bwack/CASEFANCTRLx8/pcb rework modification/oshpark_preview_front.png

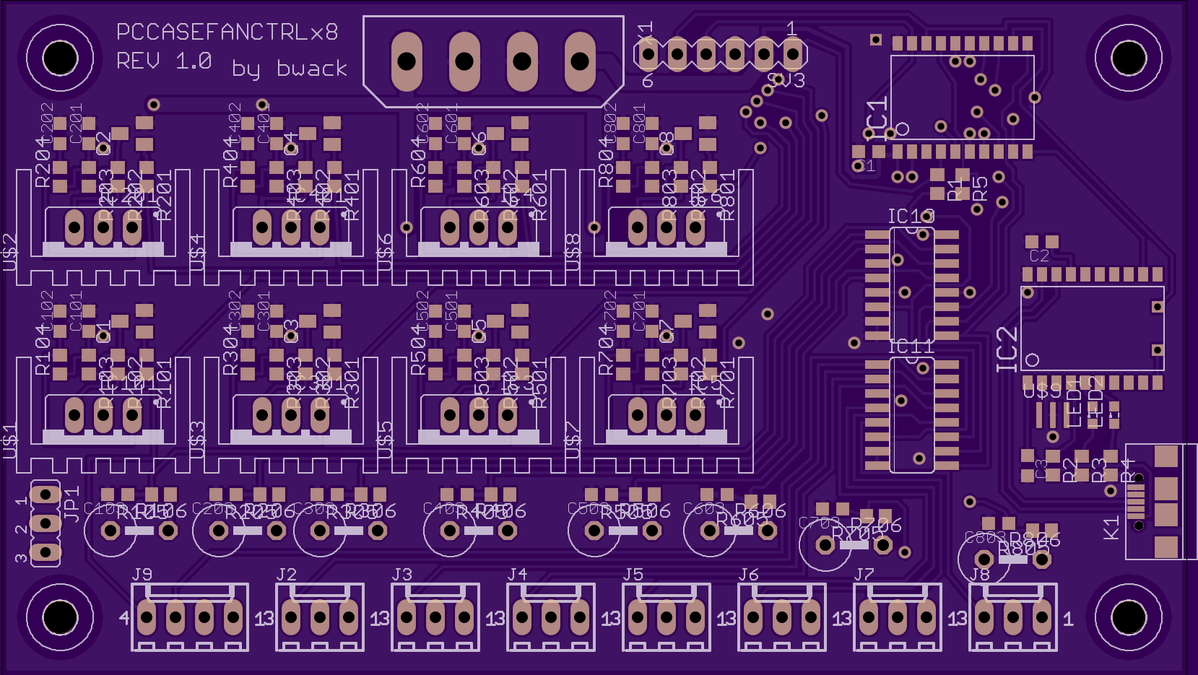
pcb rework modification/oshpark_preview_front.png
