bwack/CASEFANCTRLx8/pcb rework modification/oshpark_preview_rear_.png

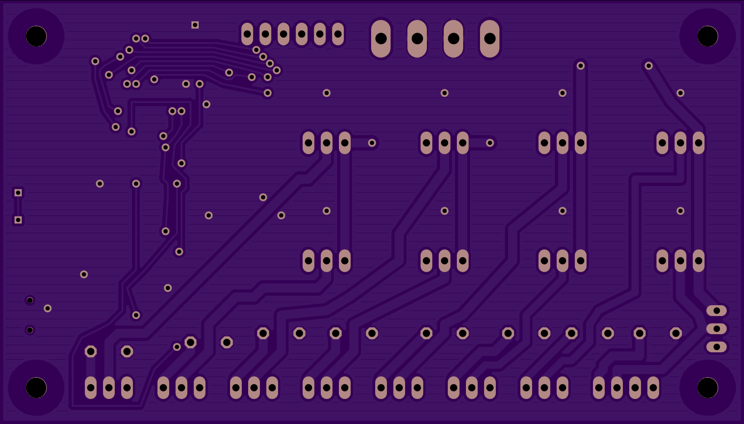
pcb rework modification/oshpark_preview_rear_.png
