bwack/CASEFANCTRLx8/pccasefanctrlx8_layout.pdf

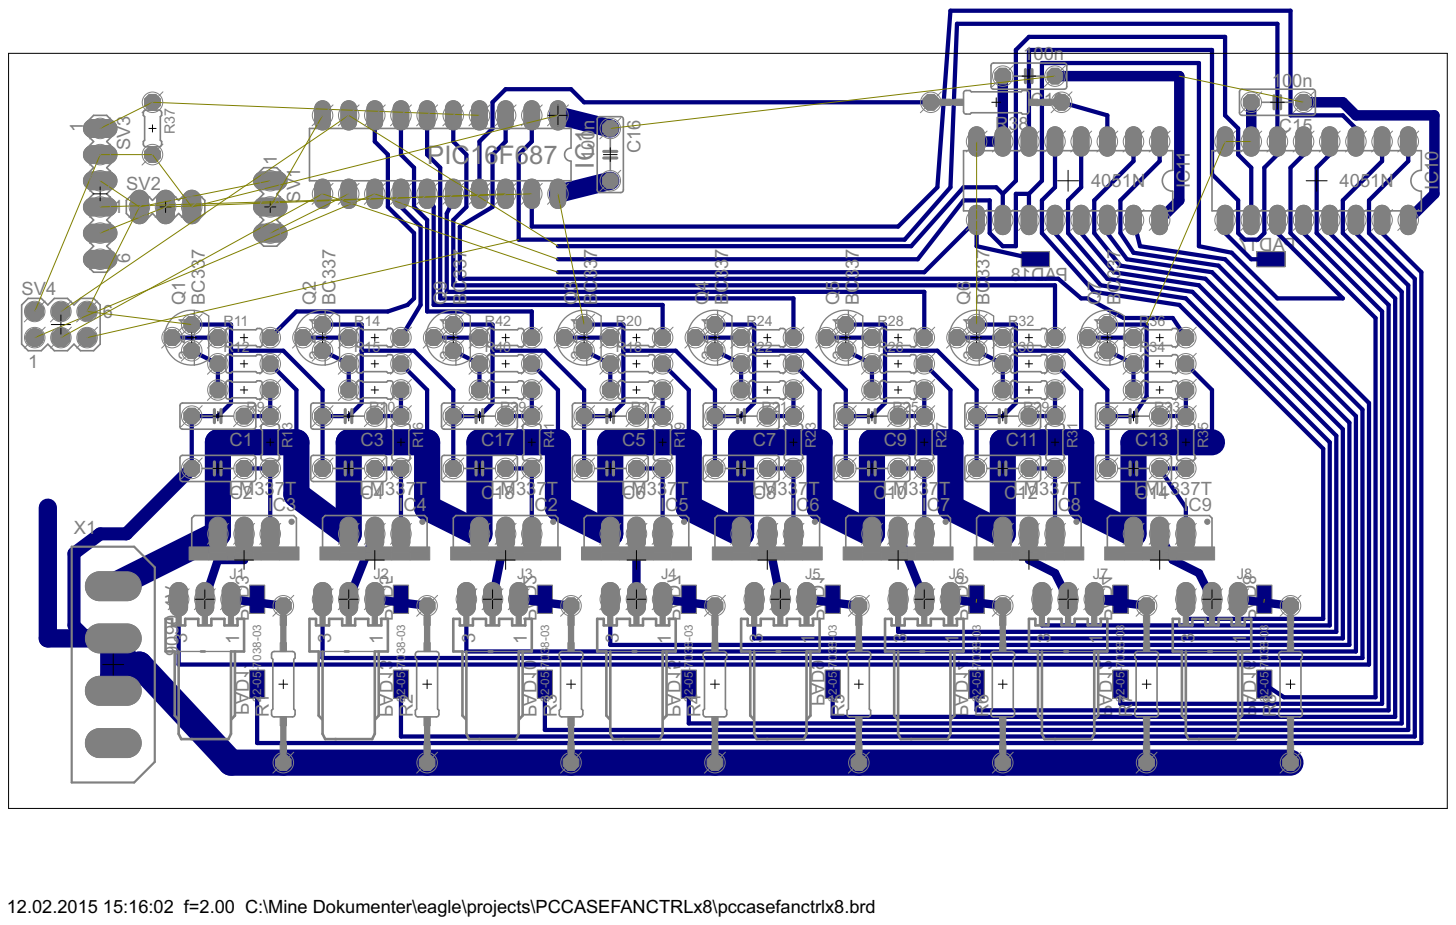
[picture p3: page 1]

12.02.2015 15:16:02 f=2.00 C:\Mine Dokumenter\eagle\projects\PCCASEFANCTRLx8\pccasefanctrlx8.brd
