bwack/CASEFANCTRLx8/pccasefanctrlx8_sch.pdf

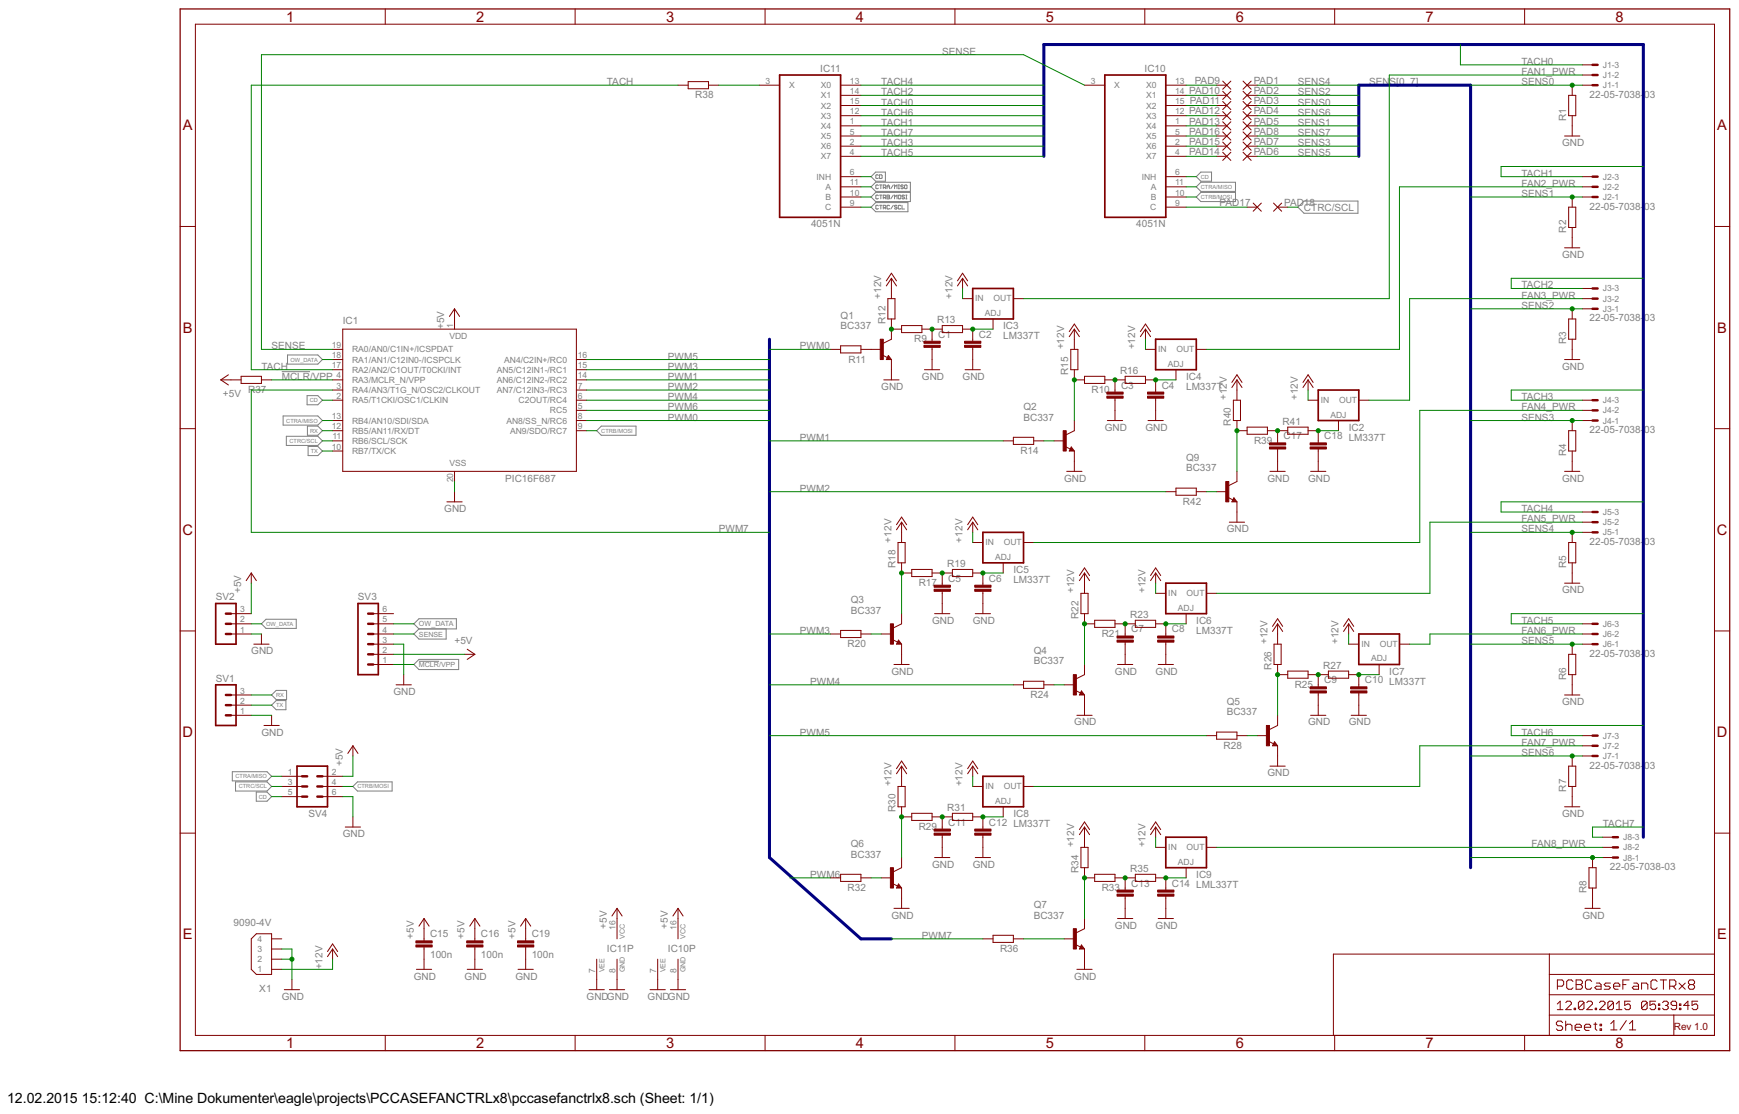
[picture p4: page 1]

12.02.2015 15:12:40 C:\Mine Dokumenter\eagle\projects\PCCASEFANCTRLx8\pccasefanctrlx8.sch (Sheet: 1/1)
