bwack/CASEFANCTRLx8/pccasefanctrlx8.brd

## EAGLE design pccasefanctrlx8.brd (2016-09-14)

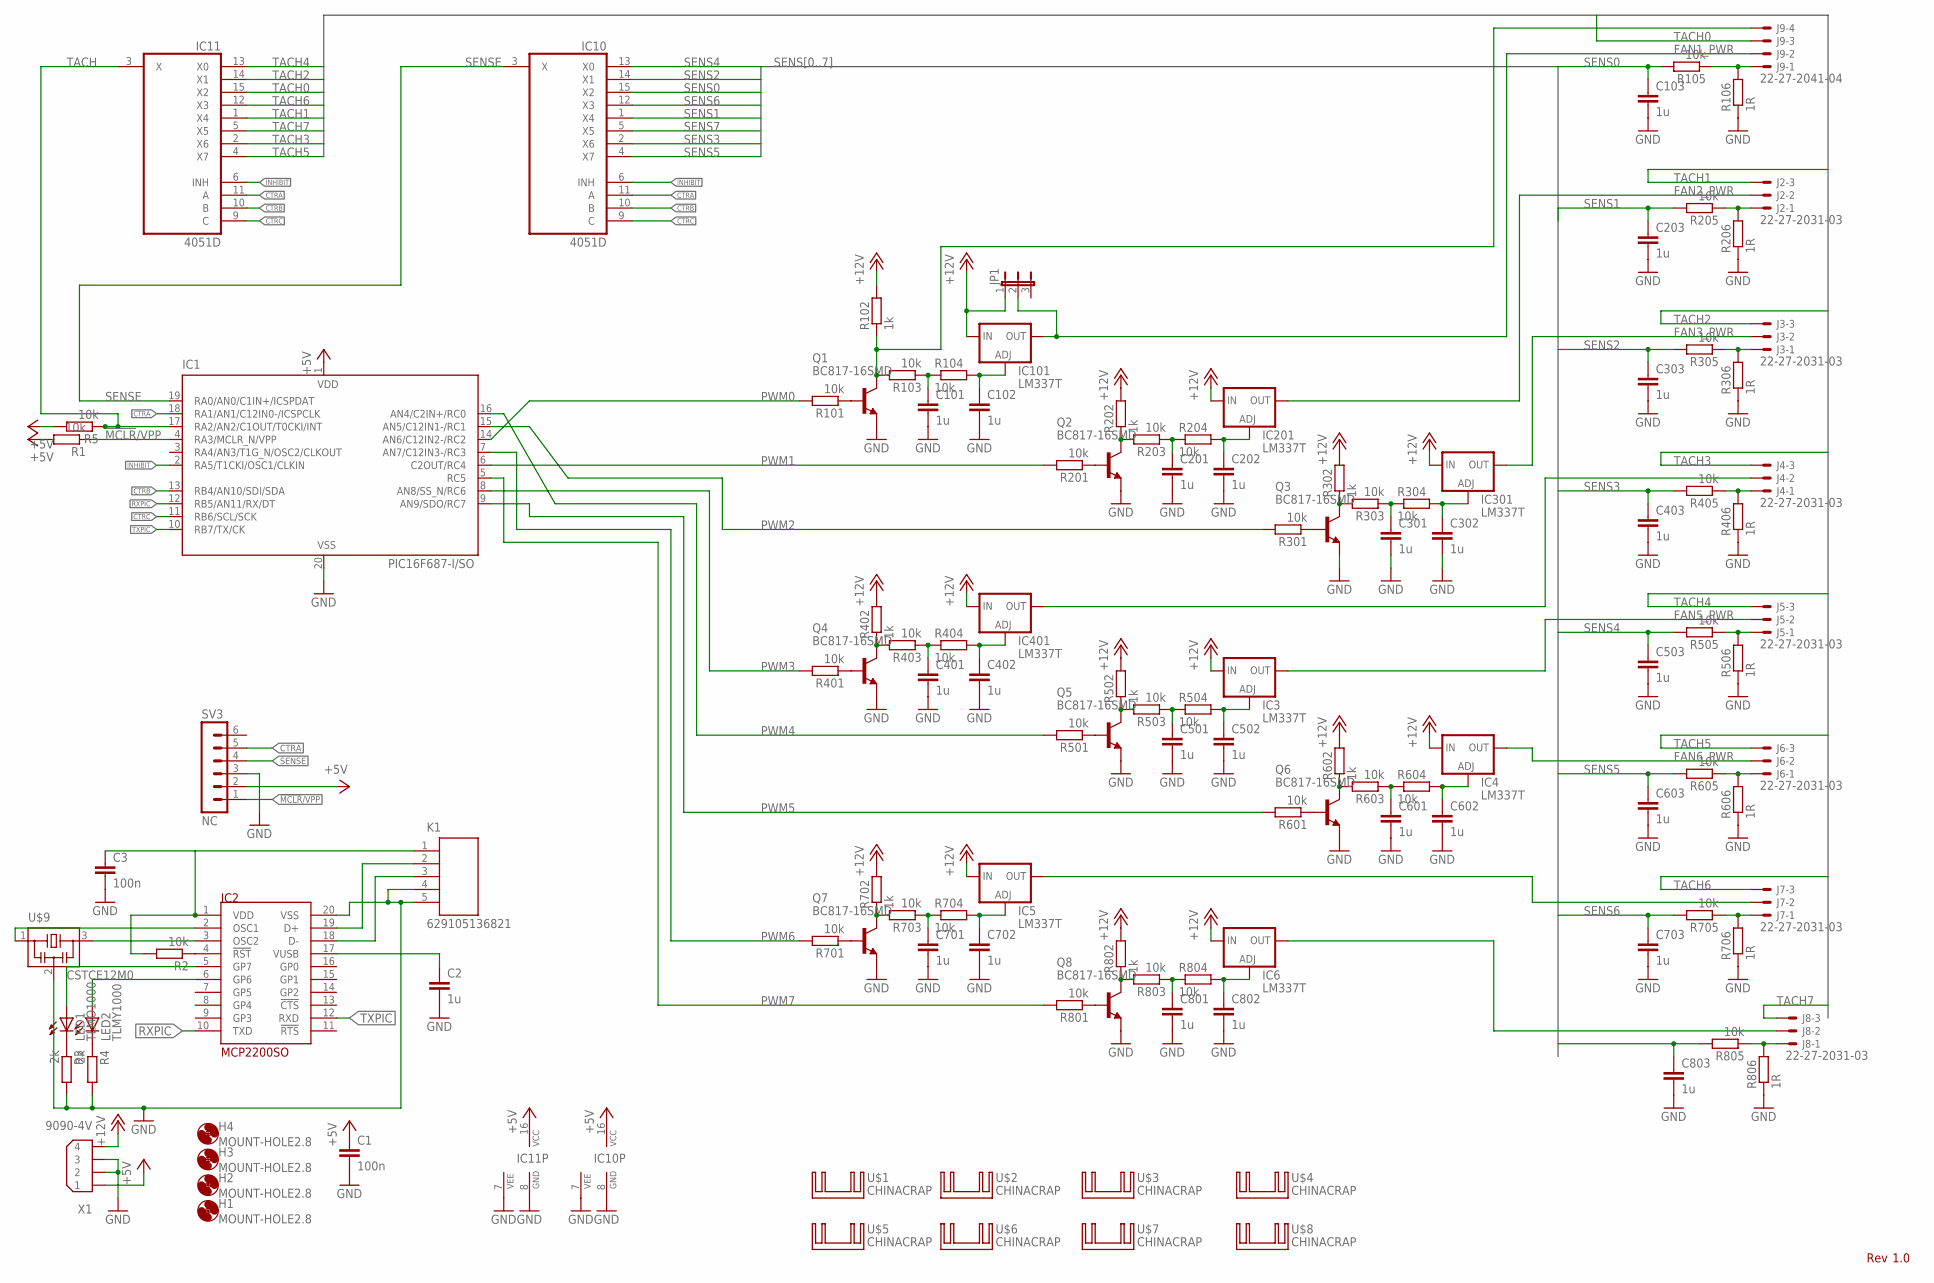
[picture p5: schematic pccasefanctrlx8.sch]

Parts:
C1, C3: 100n; C0603K
C2, C101, C102, C103, C201, C202, C203, C301, C302, C303, C401, C402, C403, C501, C502, C503, C601, C602, C603, C701, C702, C703, C801, C802, C803: 1u; C0603K
H1, H2, H3, H4: MOUNT-HOLE2.8; 2,8
IC1: PIC16F687-I/SO; SO-20W
IC2: MCP2200SO; SO-20W
IC3, IC4, IC5, IC6, IC101, IC201, IC301, IC401: LM337T; 317TS
IC10, IC11: 4051D; SO16
J2, J3, J4, J5, J6, J7, J8: 22-27-2031-03; 6410-03
J9: 22-27-2041-04; 6410-04
JP1: JP2E; JP2
K1: 629105136821
LED1: TLMO1000; SML0603
LED2: TLMY1000; SML0603
Q1, Q2, Q3, Q4, Q5, Q6, Q7, Q8: BC817-16SMD; SOT23-BEC
R1, R2, R5, R101, R103, R104, R105, R201, R203, R204, R205, R301, R303, R304, R305, R401, R403, R404, R405, R501, R503, R504, R505, R601, R603, R604, R605, R701, R703, R704, R705, R801, R803, R804, R805: 10k; R0603
R3, R4: 2k; R0603
R102, R202, R302, R402, R502, R602, R702, R802: 1k; R0603
R106, R206, R306, R406, R506, R606, R706, R806: 1R; P0613V
SV3: NC; MA06-1
U$1, U$2, U$3, U$4, U$5, U$6, U$7, U$8: CHINACRAP; MYCHINACRAP
U$9: CSTCE12M0; CSTCE_G
X1: 9090-4V

Connections:
!MCLR!/VPP: IC1.4 (RA3/MCLR_N/VPP), R1.1, SV3.1
+5V: C1.1, IC1.1 (VDD), IC10.16 (VCC), IC11.16 (VCC), R1.2, R5.2, SV3.2, X1.1
+12V: IC3.3 (IN), IC4.3 (IN), IC5.3 (IN), IC6.3 (IN), IC101.3 (IN), IC201.3 (IN), IC301.3 (IN), IC401.3 (IN), JP1.1, R102.2, R202.2, R302.2, R402.2, R502.2, R602.2, R702.2, R802.2, X1.4
CTRA: IC1.18 (RA1/AN1/C12IN0-/ICSPCLK), IC10.11 (A), IC11.11 (A), SV3.5
CTRB: IC1.13 (RB4/AN10/SDI/SDA), IC10.10 (B), IC11.10 (B)
CTRC: IC1.11 (RB6/SCL/SCK), IC10.9 (C), IC11.9 (C)
FAN1_PWR: IC101.2 (OUT), J9.2, JP1.2
FAN2_PWR: IC201.2 (OUT), J2.2
FAN3_PWR: IC301.2 (OUT), J3.2
FAN5_PWR: IC3.2 (OUT), J5.2
FAN6_PWR: IC4.2 (OUT), J6.2
GND: C1.2, C2.2, C3.2, C101.2, C102.2, C103.2, C201.2, C202.2, C203.2, C301.2, C302.2, C303.2, C401.2, C402.2, C403.2, C501.2, C502.2, C503.2, C601.2, C602.2, C603.2, C701.2, C702.2, C703.2, C801.2, C802.2, C803.2, IC1.20 (VSS), IC2.20 (VSS), IC10.7 (VEE), IC10.8 (GND), IC11.7 (VEE), IC11.8 (GND), K1.4, K1.5, Q1.E, Q2.E, Q3.E, Q4.E, Q5.E, Q6.E, Q7.E, Q8.E, R3.2, R4.2, R106.1, R206.1, R306.1, R406.1, R506.1, R606.1, R706.1, R806.1, SV3.3, U$9.2, X1.2, X1.3
INHIBIT: IC1.2 (RA5/T1CKI/OSC1/CLKIN), IC10.6 (INH), IC11.6 (INH)
unnamed: J9.4, Q1.C, R102.1, R103.2
unnamed: Q1.B, R101.1
unnamed: C201.1, R203.1, R204.1
unnamed: C101.1, R103.1, R104.1
unnamed: C102.1, IC101.1 (ADJ), R104.2
unnamed: C202.1, IC201.1 (ADJ), R204.2
unnamed: Q2.C, R202.1, R203.2
unnamed: Q2.B, R201.1
unnamed: J9.1, R105.1, R106.2
unnamed: J4.1, R405.1, R406.2
unnamed: C301.1, R303.1, R304.1
unnamed: C302.1, IC301.1 (ADJ), R304.2
unnamed: Q3.C, R302.1, R303.2
unnamed: Q3.B, R301.1
unnamed: C401.1, R403.1, R404.1
unnamed: C402.1, IC401.1 (ADJ), R404.2
unnamed: Q4.C, R402.1, R403.2
unnamed: Q4.B, R401.1
unnamed: IC401.2 (OUT), J4.2
unnamed: J2.1, R205.1, R206.2
unnamed: IC2.2 (OSC1), U$9.1
unnamed: IC2.3 (OSC2), U$9.3
unnamed: C3.1, IC2.1 (VDD), K1.1, R2.2
unnamed: IC2.4 (!RST!), R2.1
unnamed: IC2.18 (D-), K1.3
unnamed: IC2.19 (D+), K1.2
unnamed: IC2.5 (GP7), LED1.A
unnamed: C2.1, IC2.17 (VUSB)
unnamed: IC2.6 (GP6), LED2.A
unnamed: LED1.C, R3.1
unnamed: LED2.C, R4.1
unnamed: C501.1, R503.1, R504.1
unnamed: C502.1, IC3.1 (ADJ), R504.2
unnamed: Q5.C, R502.1, R503.2
unnamed: Q5.B, R501.1
unnamed: C601.1, R603.1, R604.1
unnamed: C602.1, IC4.1 (ADJ), R604.2
unnamed: Q6.C, R602.1, R603.2
unnamed: Q6.B, R601.1
unnamed: IC5.2 (OUT), J7.2
unnamed: C701.1, R703.1, R704.1
unnamed: C702.1, IC5.1 (ADJ), R704.2
unnamed: Q7.C, R702.1, R703.2
unnamed: Q7.B, R701.1
unnamed: C801.1, R803.1, R804.1
unnamed: C802.1, IC6.1 (ADJ), R804.2
unnamed: Q8.C, R802.1, R803.2
unnamed: Q8.B, R801.1
unnamed: IC6.2 (OUT), J8.2
unnamed: J3.1, R305.1, R306.2
unnamed: J6.1, R605.1, R606.2
unnamed: J7.1, R705.1, R706.2
unnamed: J8.1, R805.1, R806.2
unnamed: J5.1, R505.1, R506.2
PWM0: IC1.14 (AN6/C12IN2-/RC2), R101.2
PWM1: IC1.6 (C2OUT/RC4), R201.2
PWM2: IC1.15 (AN5/C12IN1-/RC1), R301.2
PWM3: IC1.8 (AN8/SS_N/RC6), R401.2
PWM4: IC1.16 (AN4/C2IN+/RC0), R501.2
PWM5: IC1.9 (AN9/SDO/RC7), R601.2
PWM6: IC1.7 (AN7/C12IN3-/RC3), R701.2
PWM7: IC1.5 (RC5), R801.2
RXPIC: IC1.12 (RB5/AN11/RX/DT), IC2.10 (TXD)
SENS0: C103.1, IC10.15 (X2), R105.2
SENS1: C203.1, IC10.1 (X4), R205.2
SENS2: C303.1, IC10.14 (X1), R305.2
SENS3: C403.1, IC10.2 (X6), R405.2
SENS4: C503.1, IC10.13 (X0), R505.2
SENS5: C603.1, IC10.4 (X7), R605.2
SENS6: C703.1, IC10.12 (X3), R705.2
SENS7: C803.1, IC10.5 (X5), R805.2
SENSE: IC1.19 (RA0/AN0/C1IN+/ICSPDAT), IC10.3 (X), SV3.4
TACH: IC1.17 (RA2/AN2/C1OUT/T0CKI/INT), IC11.3 (X), R5.1
TACH0: IC11.15 (X2), J9.3
TACH1: IC11.1 (X4), J2.3
TACH2: IC11.14 (X1), J3.3
TACH3: IC11.2 (X6), J4.3
TACH4: IC11.13 (X0), J5.3
TACH5: IC11.4 (X7), J6.3
TACH6: IC11.12 (X3), J7.3
TACH7: IC11.5 (X5), J8.3
TXPIC: IC1.10 (RB7/TX/CK), IC2.12 (RXD)

Notes on the sheet:
Rev

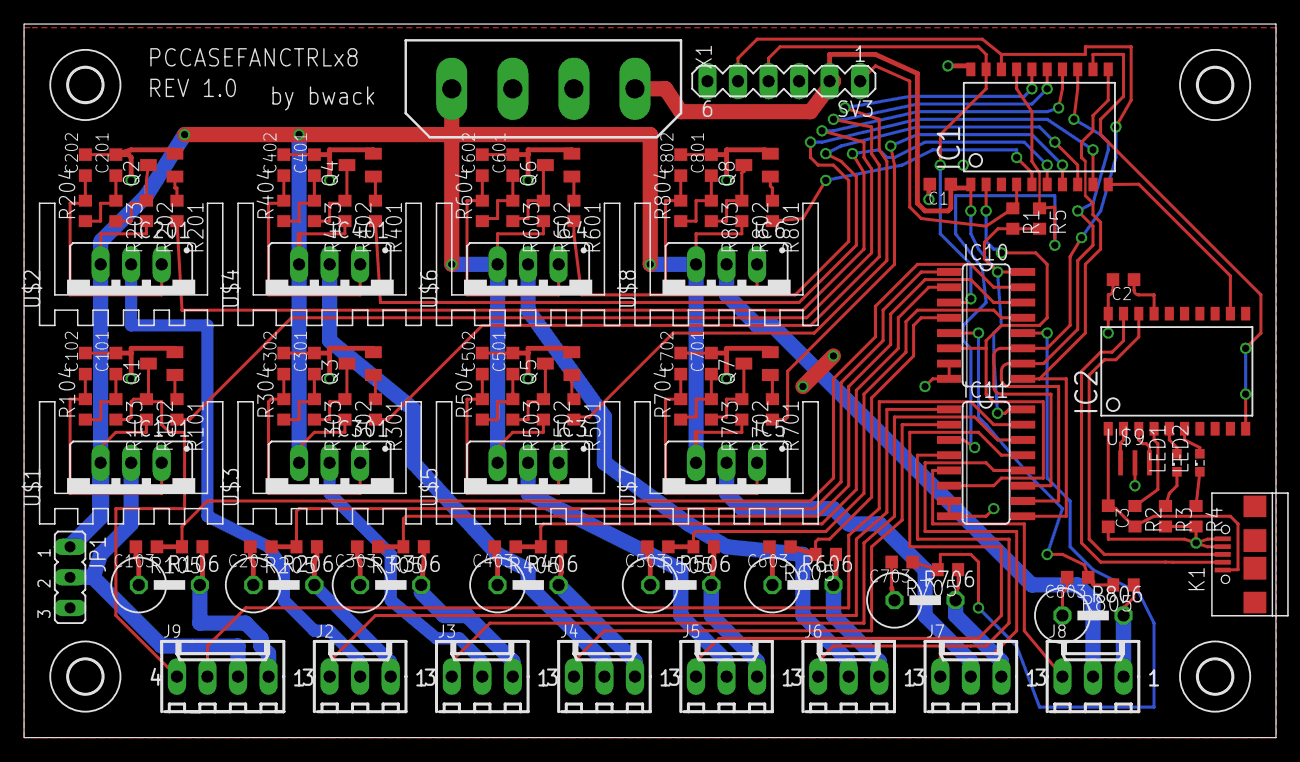
[picture p6: board pccasefanctrlx8.brd from above]

Board: 2 copper layers, 104.1 x 59.4 mm, 127 parts (0 on the bottom side), 95 nets.
