bwack/CASEFANCTRLx8/(notices)

Notices in the files:
parts and their libraries:
USBSteckverbinderWR-COM: Copyright: Würth Elektronik
